ruuvi/ruuvitag_hw/ruuvitag_revb1/ruuvitag_revb1.kicad_pcb

## KiCad design ruuvitag_revb1/ruuvitag_revb1.kicad_pcb (2015-11-08)

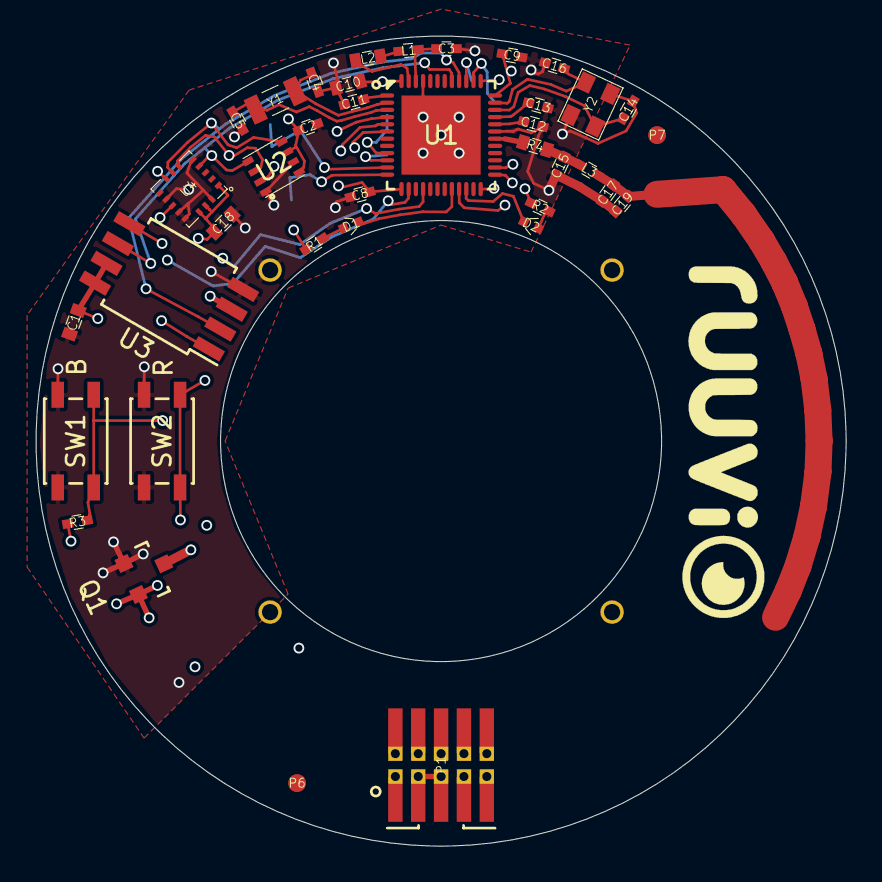
[picture p4: board ruuvitag_revb1.kicad_pcb from above]

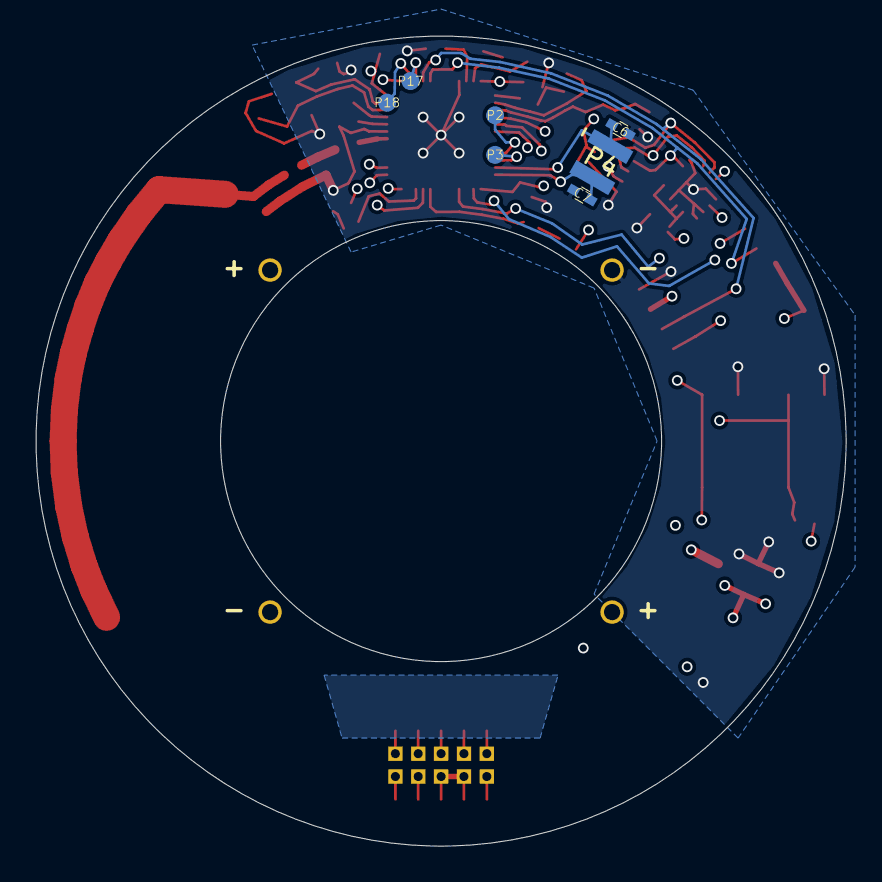
[picture p5: board ruuvitag_revb1.kicad_pcb from below]

Board: 4 copper layers, 45.0 x 45.0 mm, 49 parts (7 on the bottom side), 38 nets.

Parts:
C1, C10, C18: 4u7; 0603_GENERAL
C2, C8, C9, C11: 100n; 0402_GENERAL
C3: 1u; 0402_GENERAL
C4, C5, C14, C16: 12p; 0402_GENERAL
C6: NFCTUN1; 0402_GENERAL
C7: NFCTUN2; 0402_GENERAL
C12, C13: 100p; 0402_GENERAL
C15: 0p8; 0402_GENERAL
C17, C19: 1p2; 0402_GENERAL
D1: LED1; 0402_LED
D2: LED3; 0402_LED
L1: 15n; 0402_GENERAL
L2: 10u; 0603_GENERAL
L3: 3n9; 0402_GENERAL
P1: ARM_DEBUG; ARM_DEBUG_CONNECTOR_10PIN_ALSO_SMD
P2: UART_TX; FIDUCIAL_1MM
P3: UART_RX; FIDUCIAL_1MM
P4: NFC; 2PIN_2MM_PITCH_SMD_PIN_STRIP
P6, P7: FIDUCIAL; FIDUCIAL_1MM
P8, P9: +BATT; 09MM_PLATED_HOLE
P11, P12: GND; 09MM_PLATED_HOLE
P17: I2C_SCL; FIDUCIAL_1MM
P18: I2C_SDA; FIDUCIAL_1MM
Q1: Q_PMOS_GSD; SOT-23
R1, R2: 470; 0402_GENERAL
R3: 100k; 0402_GENERAL
R4: 0; 0603_GENERAL
SW1, SW2: SW_PUSH; SW_SPST_EVQP2
U1: nRF52832; QFN-48_6X6MM_BOTPAD
U2: BME280
U3: GENERIC_DATAFLASH; SOIJ-8_5.3x5.3mm_Pitch1.27mm
U4: ADXL363; LGA16_3X3MM
Y1: 32K; 32X15MM_2PIN_CRYSTAL
Y2: 32M; 32X25MM_4PIN_CRYSTAL

Connections:
/ACC_INT1: U1.4, U4.11
/ANTENNA: C15.1, L3.1, R4.1
/BUTTON1: R3.1, SW1.2, U1.16
/LED1: D1.1, U1.20
/LED3: D2.1, U1.22
/RESET: P1.10, SW2.2, U1.24
/SPI_ACC_CS: U1.14, U4.8
/SPI_FLASH_CS: U1.6, U3.1
/SPI_HUMI_CS: U1.5, U2.2
/SPI_MISO: U1.40, U2.5, U3.2, U4.7
/SPI_MOSI: U1.37, U2.3, U3.5, U4.6
/SPI_SCK: U1.41, U2.4, U3.6, U4.4
/SWDCLK: P1.4, U1.25
/SWDIO: P1.2, U1.26
/SWO: P1.6, U1.21
/XC1: C14.2, U1.34, Y2.1
/XC2: C16.2, U1.35, Y2.3
GND: C1.2, C2.2, C3.2, C4.1, C5.1, C6.1, C7.2, C8.1, C9.1, C10.1, C11.1, C12.1, C13.1, C14.1, C15.2, C16.1, C17.2, C18.2, C19.2, P1.3, P1.5, P1.9, P11.1, P12.1, Q1.1, SW1.1, SW2.1, U1.31, U1.45, U1.49, U2.1, U2.7, U3.4, U4.5, U4.10, U4.12, U4.13, U4.16, Y2.2, Y2.4
unnamed: C3.1, L1.2, U1.46
unnamed: C4.2, U1.2, Y1.1
unnamed: C5.2, U1.3, Y1.2
unnamed: C6.2, P4.1, U1.11
unnamed: C7.1, P4.2, U1.12
unnamed: C11.2, U1.1
unnamed: C12.2, U1.32
unnamed: C13.2, U1.33
unnamed: C17.1, C19.1, L3.2
unnamed: D1.2, R1.1
unnamed: D2.2, R2.1
unnamed: L1.1, L2.2
unnamed: L2.1, U1.47
unnamed: P2.1, U1.9
unnamed: P3.1, U1.10
unnamed: P8.1, P9.1, Q1.3
unnamed: P17.1, U1.39
unnamed: P18.1, U1.38
unnamed: R4.2, U1.30
VDD: C1.1, C2.1, C8.2, C9.2, C10.2, C18.1, P1.1, Q1.2, R1.2, R2.2, R3.2, U1.13, U1.36, U1.48, U2.6, U2.8, U3.3, U3.7, U3.8, U4.1, U4.14, U4.15
