ruuvi/ruuvitag_hw/ruuvitag_reva1/ruuvitag_reva1.kicad_pcb

## KiCad design ruuvitag_reva1/ruuvitag_reva1.kicad_pcb (2015-07-11)

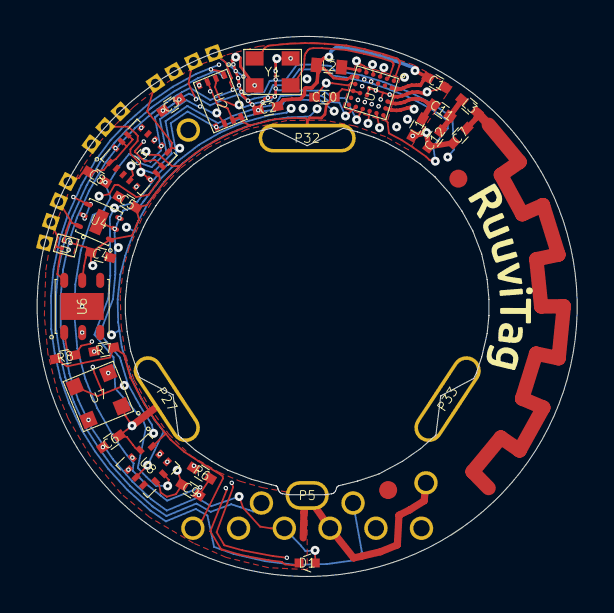
[picture p6: board ruuvitag_reva1.kicad_pcb from above]

Board: 4 copper layers, 30.0 x 30.0 mm, 55 parts (0 on the bottom side), 24 nets.

Parts:
C1, C2, C3, C4, C5, C6, C8, C9, C10: 1u; 0402_GENERAL
C7, C12: NA; 0402_GENERAL
C11: 0_ohm_resistor; 0402_GENERAL
D1: LED; 0402_LED
L1: NA; 0402_GENERAL
L2: 2u2; 0603_GENERAL
L3: 0_ohm_resistor; 0402_GENERAL
P1: SPI_SCK; 05MM_PLATED_RECT_HOLE
P2: P0_1; 05MM_PLATED_RECT_HOLE
P3: P0_2; 05MM_PLATED_RECT_HOLE
P4: P0_3; 05MM_PLATED_RECT_HOLE
P5: ENERGY_HARVESTER_GND; WIDE_PLATED_HOLE2
P6: SPI_MISO; 05MM_PLATED_RECT_HOLE
P7: SPI_MOSI; 05MM_PLATED_RECT_HOLE
P8: P0_7; 05MM_PLATED_RECT_HOLE
P9: I2C_SCL; 05MM_PLATED_RECT_HOLE
P10: I2C_SDA; 05MM_PLATED_RECT_HOLE
P11: I2C_VDD; 05MM_PLATED_RECT_HOLE
P12: I2C_GND; 05MM_PLATED_RECT_HOLE
P13, P14: FIDUCIAL; FIDUCIAL_1MM
P18: EXTRNL_PWR_(DURING_FLASHING); 09MM_PLATED_HOLE
P19: UART_TX_(FLASHING); 09MM_PLATED_HOLE
P20: UART_RX_(FLASHING); 09MM_PLATED_HOLE
P21: GND_(FLASHING); 09MM_PLATED_HOLE
P22: OTP_6V8_(FLASHING); 09MM_PLATED_HOLE
P23: SWDIO; 09MM_PLATED_HOLE
P24: SWD_CLK; 09MM_PLATED_HOLE
P25: RST_(FLASHING); 09MM_PLATED_HOLE
P27, P32, P33: +BATT; WIDE_PLATED_HOLE
P28, P34: GND; 09MM_PLATED_HOLE
R6: 470; 0402_GENERAL
R7, R8: 10k; 0402_GENERAL
U1: DA1458X_WLCSP34; WLCSP34
U2: GENERIC_DATAFLASH; USON8_2X3MM
U3: LIS331DLH; LGA16_3X3MM
U4: OPT3001; USON6_2X2MM_WITHTHRMLPAD
U5: AT30TS74_WLCSP; WLCSP4
U6: Si7006; DFN6_3X3MM
U7: MS5637
U8: UVIS25
Y1: 16M; 32X25MM_4PIN_CRYSTAL

Connections:
/ACC_INT1: P2.1, U1.B5, U3.11
/ACC_INT2: P8.1, U1.E5, U3.9, U4.5, U8.7
/ANTENNA: C11.1, L1.2, U1.A4
/I2C_SCL: P9.1, R7.1, U1.E2, U4.4, U5.B2, U6.6, U7.3, U8.2
/I2C_SDA: P10.1, R8.2, U1.D2, U4.6, U5.B1, U6.1, U7.2, U8.4
/LED: D1.1, P19.1, U1.D5
/OTP_6V8_VIN: P22.1, U1.A6
/P1_4: P24.1, U1.C1
/P1_5: P23.1, U1.D1
/RST: P25.1, U1.E3
/SPI_ACC_CS: P3.1, U1.C5, U3.8
/SPI_FLASH_CS: P4.1, U1.C6, U2.1
/SPI_MISO: P6.1, P20.1, U1.D6, U2.2, U3.7
/SPI_MOSI: P7.1, U1.E6, U2.5, U3.6
/SPI_SCK: P1.1, U1.B6, U2.6, U3.4
/VDCDC: C1.1, C2.1, L2.2, U1.A2, U1.F2
GND: C1.2, C2.2, C3.2, C4.2, C5.2, C6.2, C7.2, C8.2, C9.2, C10.2, C12.2, L1.1, P5.1, P12.1, P21.1, P28.1, P34.1, R6.2, U1.A3, U1.A5, U1.B4, U1.C3, U1.D3, U1.D4, U1.E1, U1.F3, U2.4, U3.5, U3.10, U3.12, U3.13, U3.16, U4.2, U4.3, U4.7, U5.A2, U6.2, U6.7, U7.4, U8.3, U8.8, U8.9, Y1.2, Y1.4
unnamed: C7.1, L3.2
unnamed: C11.2, C12.1, L3.1
unnamed: D1.2, R6.1
unnamed: L2.1, U1.F1
unnamed: U1.A1, Y1.1
unnamed: U1.B1, Y1.3
VDD: C3.1, C4.1, C5.1, C6.1, C8.1, C9.1, C10.1, P11.1, P18.1, P27.1, P32.1, R7.2, R8.1, U1.E4, U1.F4, U2.3, U2.7, U2.8, U3.1, U3.14, U3.15, U4.1, U5.A1, U6.5, U7.1, U8.1, U8.6, U8.10
