ruuvi/ruuvitag_hw/(notices)

Notices in the files:
ruuvitag_reva2/ruuvitag_reva2.sch:
http://creativecommons.org/licenses/by-sa/4.0
License: Attribution-ShareAlike 4.0 International (CC BY-SA 4.0)
ruuvitag_revb8/ruuvitag_revb8.sch:
License: http://creativecommons.org/licenses/by-sa/4.0
